Schenktronics/ST02-levels/docs/BOM.csv

Qty | Reference | Description | Manufacturer | Part Number | Link
4 | J1-J4 | 3.5mm mono switched jack, vertical, with nut (J3 must be switched. The oval pads also take panel-mount jacks such as CUI MJ-3507, with a wire from the sleeve lug to the square pad) | QingPu | WQP-PJ398SM or WQP518MA | http://www.qingpu-electronics.com/en/products/WQP-PJ398SM-362.html
2 | RV1, RV2 | Potentiometer, 100k linear, 9mm, vertical PCB mount with board-lock lugs, 6mm D shaft (20mm long), bushingless, no nut (or equivalent) | Bourns | PTV09A-4020F-B104 | https://www.mouser.com/en/ProductDetail/Bourns/PTV09A-4020F-B104
2 |  | Knob, 12mm, fits pot shaft directly, not skirted (or equivalent) | Davies Molding | 1221-J | https://www.mouser.com/en/ProductDetail/Davies-Molding/1221-J
1 |  | Main PCB, 15x100mm, 2-layer, 1.6mm | Schenktronics | ST-02 Levels v1.1
1 |  | Faceplate, 3HP, 1.6mm aluminum PCB | Schenktronics | ST-02 Levels Faceplate
