Schenktronics/ST02-levels/hardware/jig/ST-02_Solder_Jig.stl

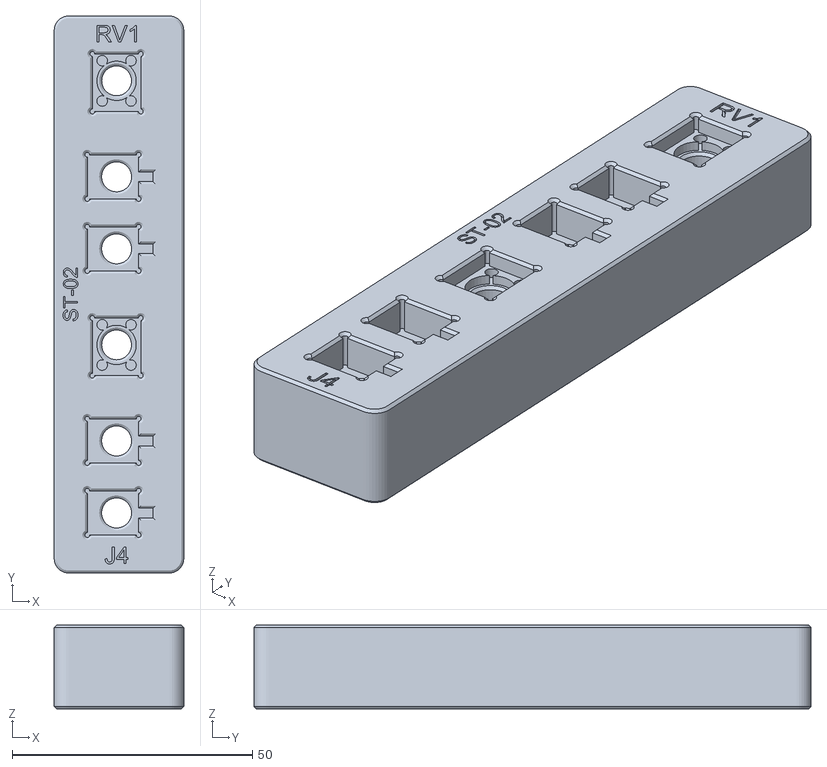
[picture p1: CAD file, 2026-10-28]
hardware/jig/ST-02_Solder_Jig.stl
27.0 x 116.0 x 17.5
