Schenktronics/ST02-levels/hardware/levels/Levels.step

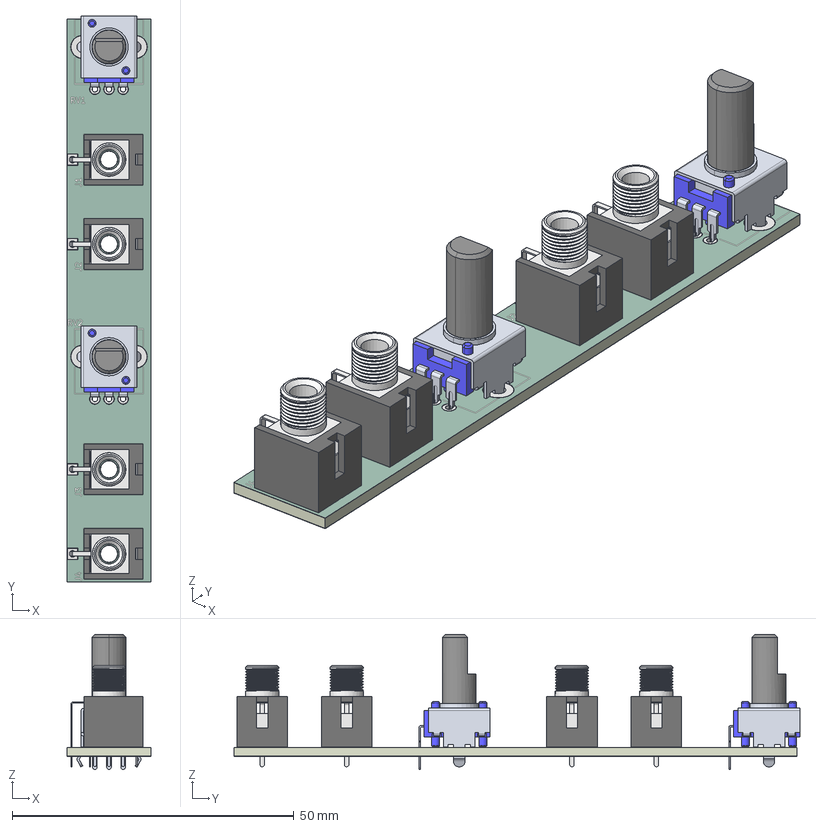
[picture p2: CAD file, 2026-11-01]
hardware/levels/Levels.step
15.0 x 100.5 x 24.0 mm
Thonkiconn - PJ398SM v10 x 4
PTV09A-4X20F-XXXCX_2 x 2
PTV09A-4X20F-XXXCX x 2
Levels_copper
Levels_pad
Levels_silkscreen x 2
Levels_soldermask x 2
Levels_PCB
