Schenktronics/ST02-levels/hardware/panel/LevelsFaceplate.step

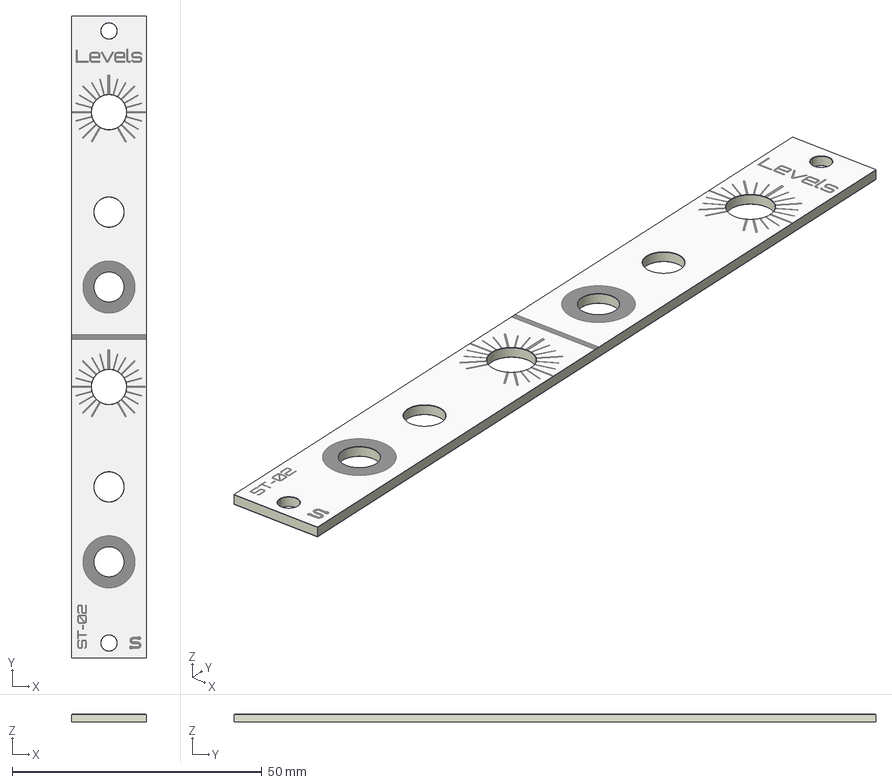
[picture p3: CAD file, 2026-11-01]
hardware/panel/LevelsFaceplate.step
15.0 x 128.5 x 1.64 mm
LevelsFaceplate_copper
LevelsFaceplate_silkscreen
LevelsFaceplate_soldermask x 2
LevelsFaceplate_PCB
