Schenktronics/ST02-levels/hardware/ST-02_Levels.step

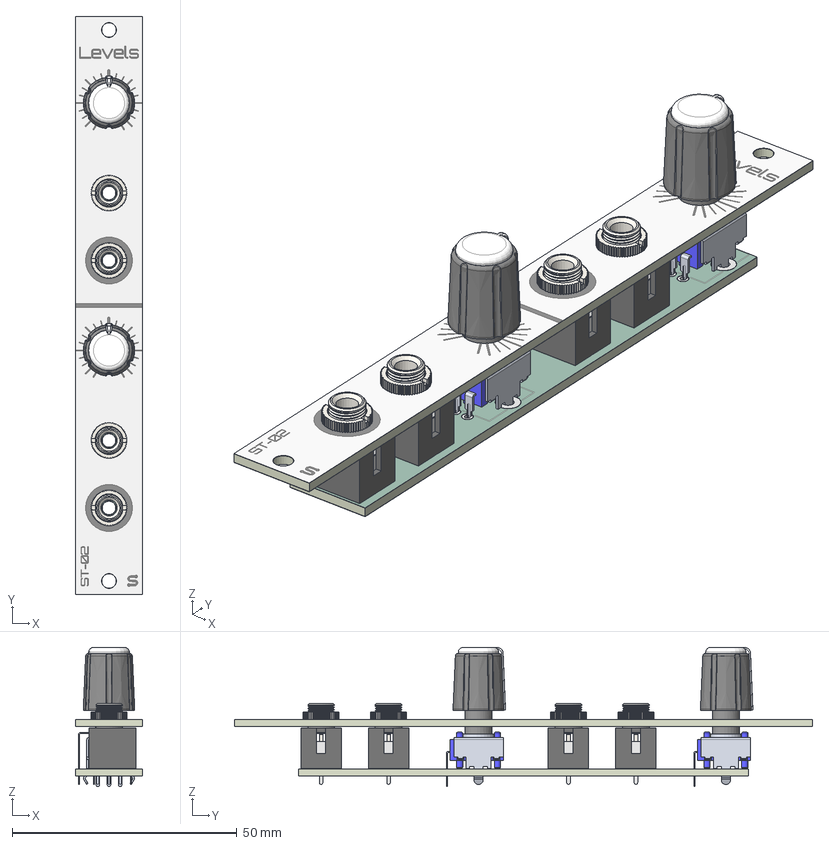
[picture p4: CAD file, 2026-11-01]
hardware/ST-02_Levels.step
15.0 x 128.5 x 30.9 mm
LevelsFaceplate_copper
LevelsFaceplate_silkscreen
LevelsFaceplate_soldermask
LevelsFaceplate_soldermask_1
LevelsFaceplate_PCB
Thonkiconn - PJ398SM v10 x 4
PTV09A-4X20F-XXXCX_2 x 2
PTV09A-4X20F-XXXCX x 2
Levels_copper
Levels_pad
Levels_silkscreen
Levels_silkscreen_1
Levels_soldermask
Levels_soldermask_1
Levels_PCB
1221-J x 2
