Schenktronics/ST02-levels/(commit log)

2026-10-17 Polish the ST-02 Levels docs for launch: v1.1 boards, naming, PDF names
    The boards are silkscreened "ST-02 v1.1 / Levels", so the BOM, PDF
    covers, and the assembly guide now say v1.1, and the guide describes
    the back of the board as it's actually printed.
    Titles and headings use "ST-02 Levels", body text uses "Levels". The
    PDFs are renamed to ST-02_Levels_User_Manual.pdf and
    ST-02_Levels_Assembly_Guide.pdf before launch.
    The manual and assembly guide are reworded in Nathan's voice, with the
    same additions as the ST-01 guide: first-time soldering tips, rubber
    bands to hold the faceplate, squaring up the jacks, and no lead
    trimming. American spelling, the Oxford comma, and keyboard punctuati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
    [BOM.csv]
2026-10-17 Square up the jacks before soldering, snug the nuts last
    Nathan's refined build order: hand-tighten the jack nuts, square up the
    jack bodies with small pliers, center the parts, solder everything, and
    only then snug the nuts down. The faceplate drawing's caption now reads
    "..., solder, then tighten the nuts", and its nut label says
    "hand-tighten first".
2026-10-17 Add solder and lead-handling advice to the assembly guide
    The Tools list asks for 0.8 mm flux-core solder and safety glasses,
    without recommending leaded or lead-free, and the iron line notes that
    lead-free runs a little hotter. "First time soldering?" says 63/37 or
    60/40 leaded solder is easier to learn with and leaves the choice to
    the builder, with handling advice for leaded solder (wash hands, no
    eating, drinking, or smoking while soldering, wipe the work surface,
    keep it away from kids) and a separate note on ventilation and flux
    fumes.
2026-10-17 Explain the oval jack pads with the CUI MJ-3507, drop the Mouser project
    The jack pads are oval so the board also takes panel-mount style jacks.
    The README, the BOM's jack row, and a new "Using panel-mount style
    jacks?" note in the assembly guide now say so with one example, the
    CUI MJ-3507, whose sleeve is a solder lug that needs a short wire to
    the square pad. QingPu stays the main part in the BOM.
    The out-of-date Mouser project link and the BOM's "Ordering the
    parts" section are removed.
    [BOM.csv]
2026-10-17 Fix the jack pad orientation in the assembly drawings
    The drawing script added the footprint's rotation to each pad's angle,
    but KiCad stores the pad angle with the footprint rotation already
    included, so every oval jack pad was drawn rotated 90 degrees. Checked
    against kicad-cli's render of the board.
2026-10-28 Add a 3D-printable solder jig
    The jig holds the two pots and four jacks square and centered while
    they are soldered, in place of the faceplate, so all six parts can be
    soldered in one go. Exported from ST-02 Solder Jig v0. The pocket
    mouths have a 0.5 mm lead-in chamfer, and the shaft bores a 0.5 mm one,
    so the loose-fitted parts find their pockets; both were added after the
    first test build. The README gives the print settings and the order of
    use: parts into the PCB, jig over them, flip, solder.
    [ST-02_Solder_Jig.stl]
2026-10-28 Assembly guide: building with the solder jig
    The guide assumed the faceplate was the only way to align the pots and
    jacks. It now lists the printed jig as an optional tool and gives the
    jig build: parts into the PCB, jig over them, flip, solder all 22
    joints, then faceplate and nuts, with Step 3 skipped.
2026-11-01 Faceplate back shows as aluminum in 3D; re-export STEP files
    [Levels.step, LevelsFaceplate.kicad_pcb, LevelsFaceplate.step]
2026-11-01 Assembly STEP from Fusion: new 1221-J knobs, current board and faceplate
    [ST-02_Levels.step]
